fmalpartida/hobby-lights/README.md

# hobby-lights
Small light sequencer for hobby projects.
