fmalpartida/hobby-lights/hw/hobbyLights.brd

## EAGLE design hw/hobbyLights.brd (2016-06-05)

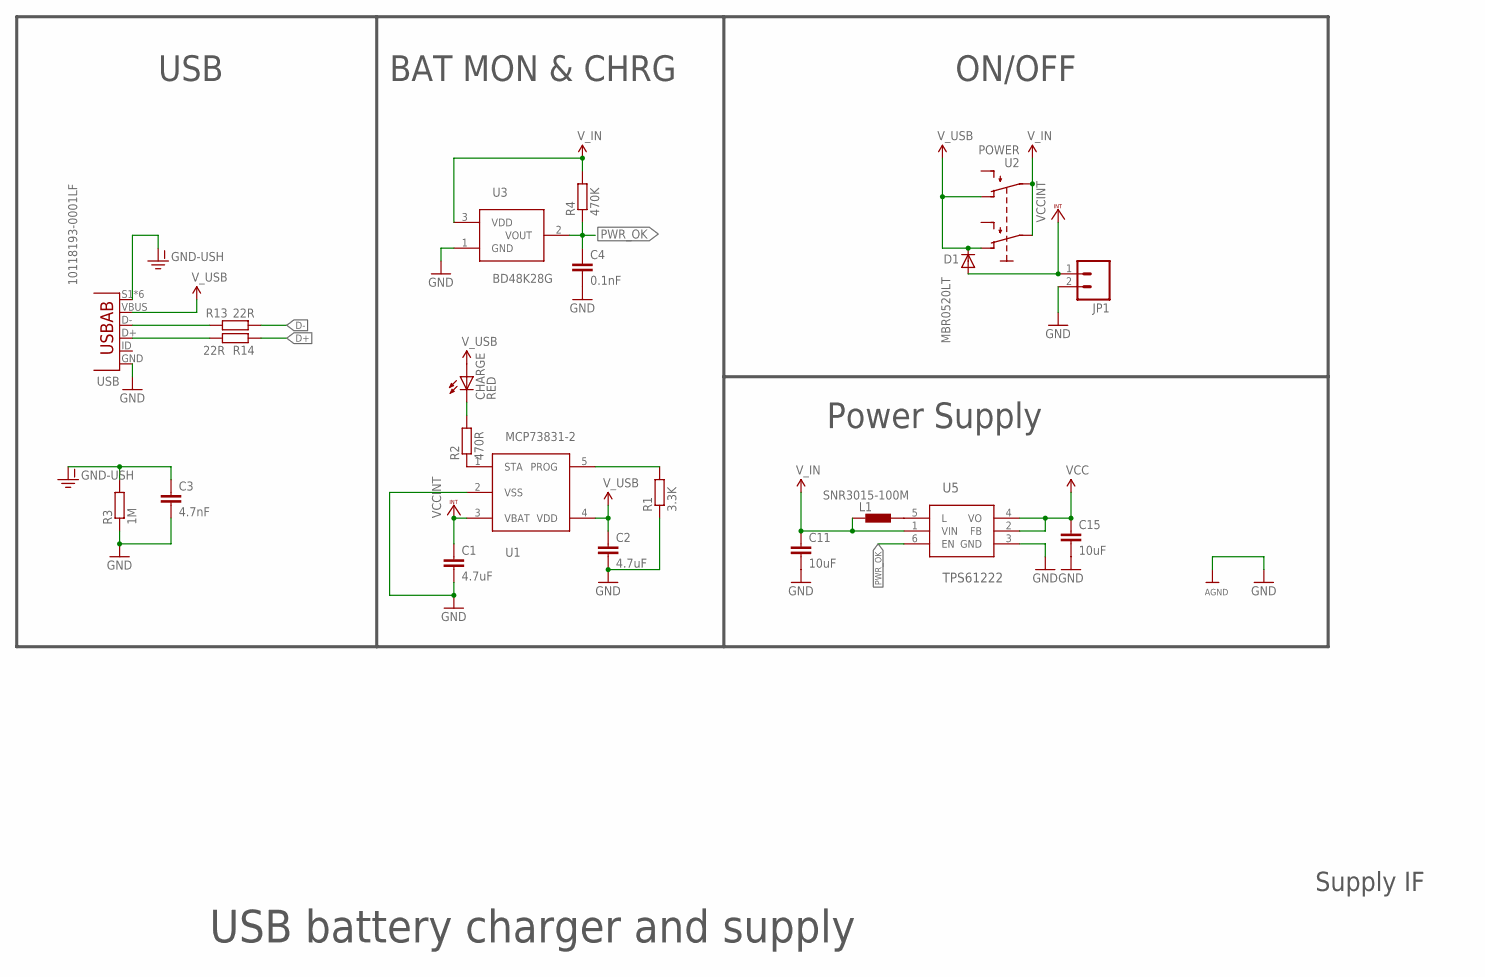
[picture p1: schematic hobbyLights.sch, sheet 1]

Parts:
C1, C2: 4.7uF; C0805
C3: 4.7nF; C0603
C4: 0.1nF; C0603
C11, C15: 10uF; C0805
CHARGE: RED; CHIPLED_0805
D1: MBR0520LT; SOD123
JP1: SPARKFUN_M02POLAR; SPARKFUN_MOLEX-1X2
L1: SNR3015-100M; SRN3015
R1: 3.3K; R0603
R2: 470R; R0603
R3: 1M; R0603
R4: 470K; R0603
R13, R14: 22R; R0603
U1: MCP73831-2; SOT23-5
U2: POWER; SWITCH-JS202011
U3: BD48K28G; SSOP3
U5: TPS61222; DCK
USB: 10118193-0001LF; USB_MICRO_B

Connections:
D+: R14.1; also elsewhere on the board
D-: R13.1; also elsewhere on the board
GND: C1.2, C2.2, C3.2, C4.2, C11.2, C15.2, JP1.2, R1.1, R3.1, U1.2 (VSS), U3.1 (GND), U5.3 (GND), USB.GND; also elsewhere on the board
GND-ISO: C3.1, R3.2, USB.S1 (SHIELD), USB.S2 (SHIELD), USB.S3 (SHIELD), USB.S4 (SHIELD), USB.S5 (SHIELD), USB.S6 (SHIELD)
unnamed: R1.2, U1.5 (PROG)
unnamed: R2.1, U1.1 (STA)
unnamed: CHARGE.C, R2.2
unnamed: R13.2, USB.D-
unnamed: R14.2, USB.D+
unnamed: L1.2, U5.5 (L)
PWR_OK: C4.1, R4.1, U3.2 (VOUT), U5.6 (EN)
VCC: C15.1, U5.2 (FB), U5.4 (VO); also elsewhere on the board
VCCINT: C1.1, D1.A, JP1.1, U1.3 (VBAT)
V_BATT: C11.1, L1.1, R4.2, U2.P2, U2.P5 (P1), U3.3 (VDD), U5.1 (VIN)
V_USB: C2.1, CHARGE.A, D1.C, U1.4 (VDD), U2.P1 (O), U2.P4 (O1), USB.VBUS

Notes on the sheet:
USB
BAT MON & CHRG
Power Supply
ON/OFF
USB battery charger and supply
Supply IF

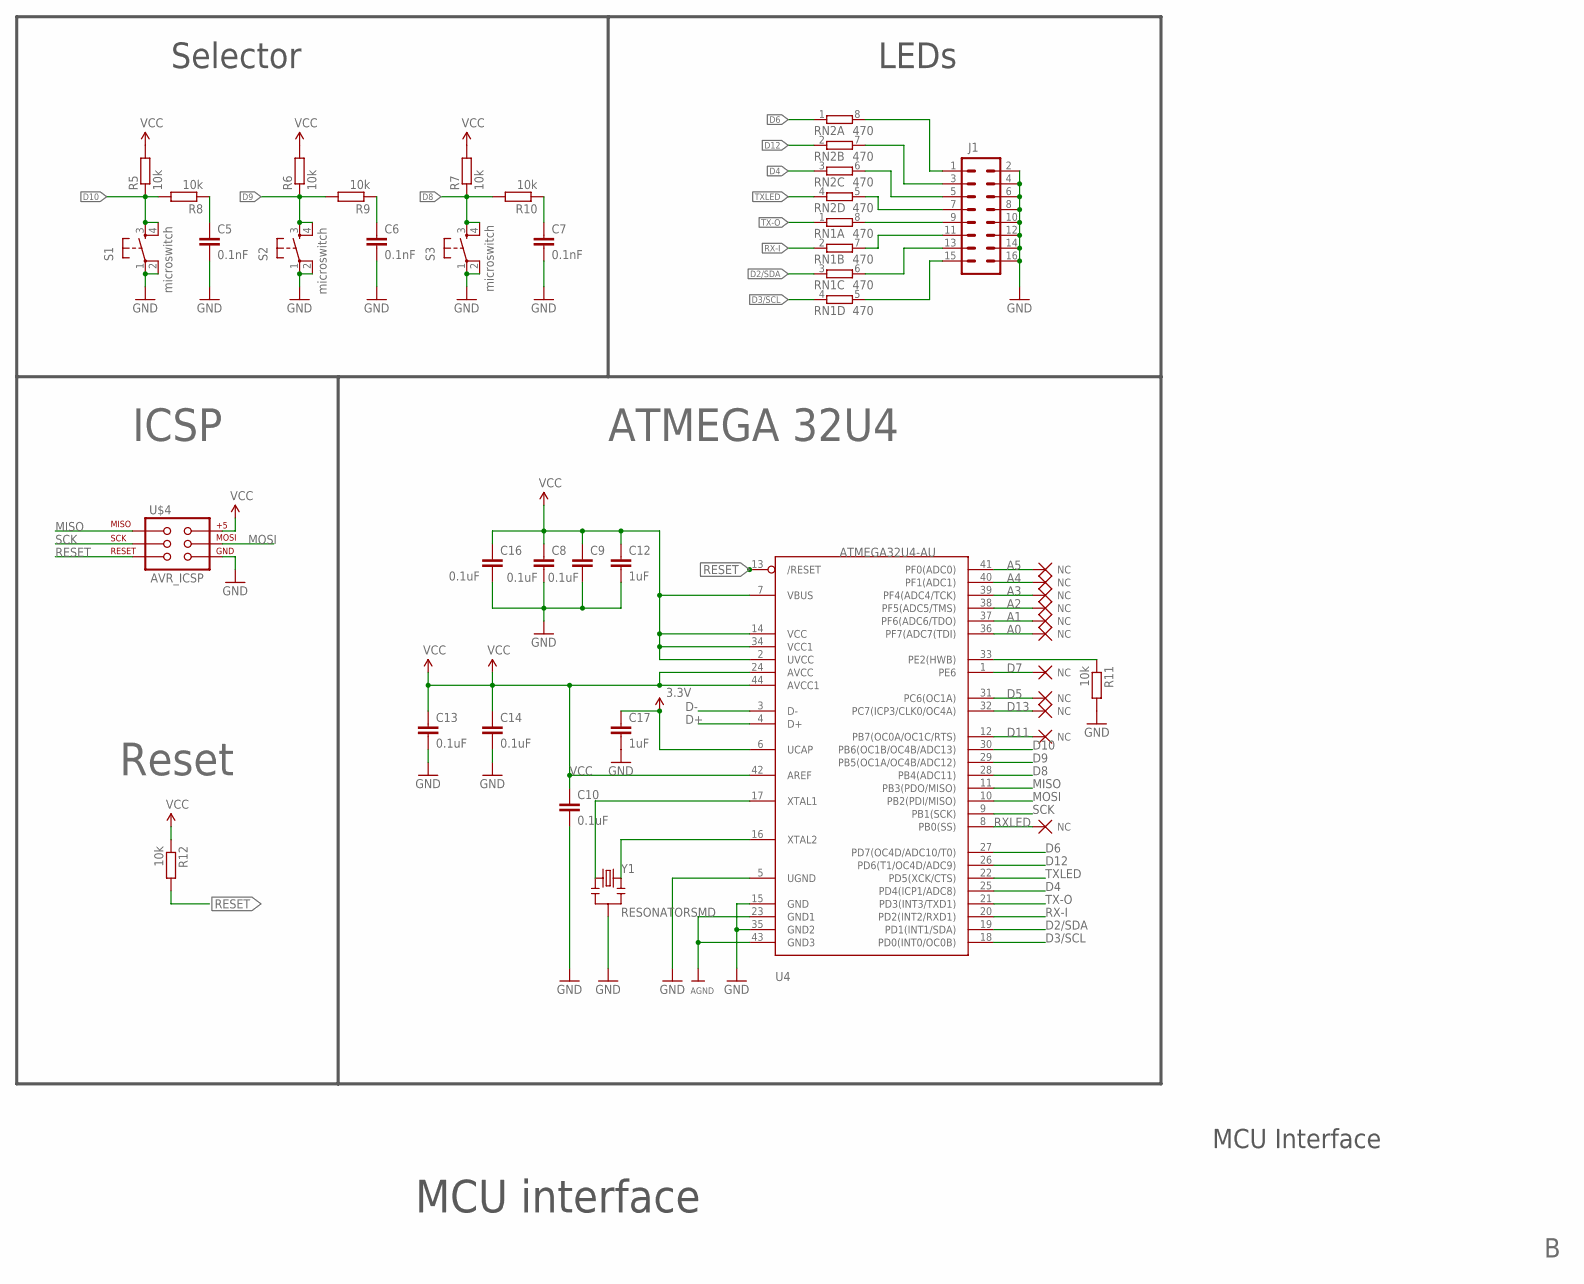
[picture p2: schematic hobbyLights.sch, sheet 2]

Parts:
C5, C6, C7: 0.1nF; C0603
C8, C9, C10, C13, C14, C16: 0.1uF; C0603
C12, C17: 1uF; C0603
J1: M08X2; 2X8
R5, R6, R7, R8, R9, R10, R11, R12: 10k; R0603
RN1, RN2: 470; EXBS8V
S1, S2, S3: microswitch; SPARKFUN_TACTILE_SWITCH_SMD
U4: ATMEGA32U4-AU; ADAFRUIT_TQFP44
U$4: AVR_ICSP; ICSP_SMD
Y1: RESONATORSMD; RESONATOR-SMD

Connections:
3.3V: C17.1, U4.6 (UCAP)
A0: U4.36 (PF7(ADC7(TDI))
A1: U4.37 (PF6(ADC6/TDO))
A2: U4.38 (PF5(ADC5/TMS))
A3: U4.39 (PF4(ADC4/TCK))
A4: U4.40 (PF1(ADC1))
A5: U4.41 (PF0(ADC0))
D2/SDA: RN1.3 (1), U4.19 (PD1(INT1/SDA))
D3/SCL: RN1.4 (1), U4.18 (PD0(INT0/OC0B))
D4: RN2.3 (1), U4.25 (PD4(ICP1/ADC8))
D5: U4.31 (PC6(OC1A))
D6: RN2.1, U4.27 (PD7(OC4D/ADC10/T0))
D7: U4.1 (PE6)
D8: R7.1, R10.2, S3.3, S3.4, U4.28 (PB4(ADC11))
D9: R6.1, R9.2, S2.3, S2.4, U4.29 (PB5(OC1A/OC4B/ADC12))
D10: R5.1, R8.2, S1.3, S1.4, U4.30 (PB6(OC1B/OC4B/ADC13))
D11: U4.12 (PB7(OC0A/OC1C/RTS))
D12: RN2.2 (1), U4.26 (PD6(T1/OC4D/ADC9))
D13: U4.32 (PC7(ICP3/CLK0/OC4A))
D+: U4.4 (D+); also elsewhere on the board
D-: U4.3 (D-); also elsewhere on the board
GND: C5.2, C6.2, C7.2, C8.2, C9.2, C10.2, C12.2, C13.2, C14.2, C16.2, C17.2, J1.2, J1.4, J1.6, J1.8, J1.10, J1.12, J1.14, J1.16, R11.2, S1.1, S1.2, S2.1, S2.2, S3.1, S3.2, U4.5 (UGND), U4.15 (GND), U4.23 (GND1), U4.35 (GND2), U4.43 (GND3), U$4.GND, Y1.2; also elsewhere on the board
MISO: U4.11 (PB3(PDO/MISO)), U$4.MISO
MOSI: U4.10 (PB2(PDI/MISO)), U$4.MOSI
unnamed: C5.1, R8.1
unnamed: U4.16 (XTAL2), Y1.3
unnamed: U4.17 (XTAL1), Y1.1
unnamed: C6.1, R9.1
unnamed: C7.1, R10.1
unnamed: R11.1, U4.33 (PE2(HWB))
unnamed: J1.15, RN1.5 (2)
unnamed: J1.13, RN1.6 (2)
unnamed: J1.11, RN1.7 (2)
unnamed: J1.9, RN1.8 (2)
unnamed: J1.1, RN2.8 (2)
unnamed: J1.3, RN2.7 (2)
unnamed: J1.5, RN2.6 (2)
unnamed: J1.7, RN2.5 (2)
RESET: R12.2, U4.13 (/RESET), U$4.RESET
RX-I: RN1.2 (1), U4.20 (PD2(INT2/RXD1))
RXLED: U4.8 (PB0(SS))
SCK: U4.9 (PB1(SCK)), U$4.SCK
TX-O: RN1.1, U4.21 (PD3(INT3/TXD1))
TXLED: RN2.4 (1), U4.22 (PD5(XCK/CTS))
VCC: C8.1, C9.1, C10.1, C12.1, C13.1, C14.1, C16.1, R5.2, R6.2, R7.2, R12.1, U4.2 (UVCC), U4.7 (VBUS), U4.14 (VCC), U4.24 (AVCC), U4.34 (VCC1), U4.42 (AREF), U4.44 (AVCC1), U$4.5V (+5V); also elsewhere on the board

Notes on the sheet:
ATMEGA 32U4
Reset
ICSP
Selector
LEDs
MCU interface
MCU Interface

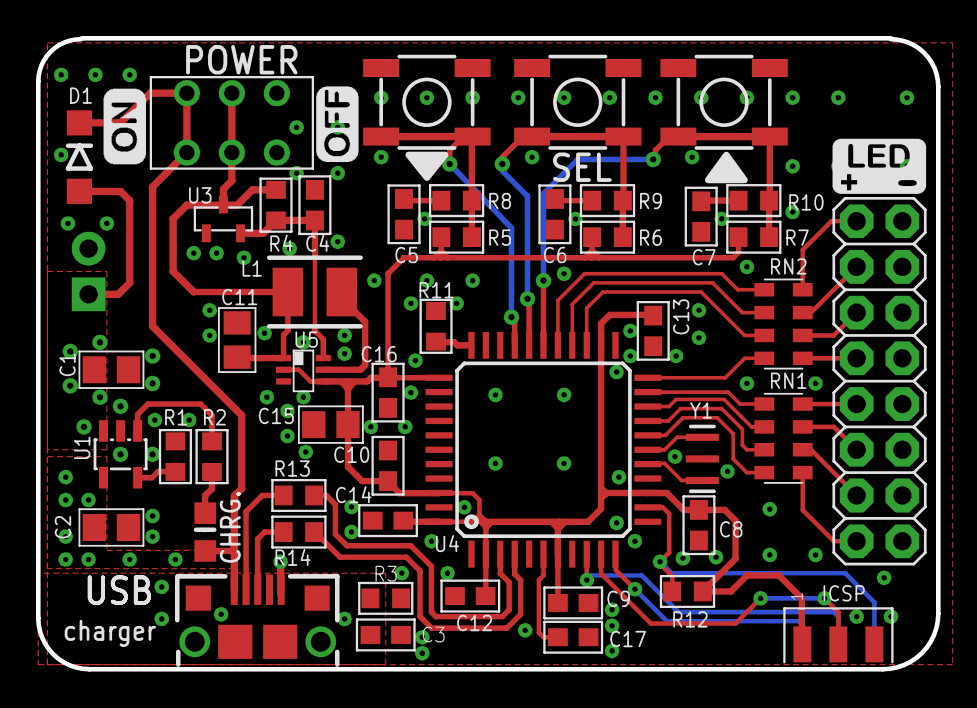
[picture p3: board hobbyLights.brd from above]

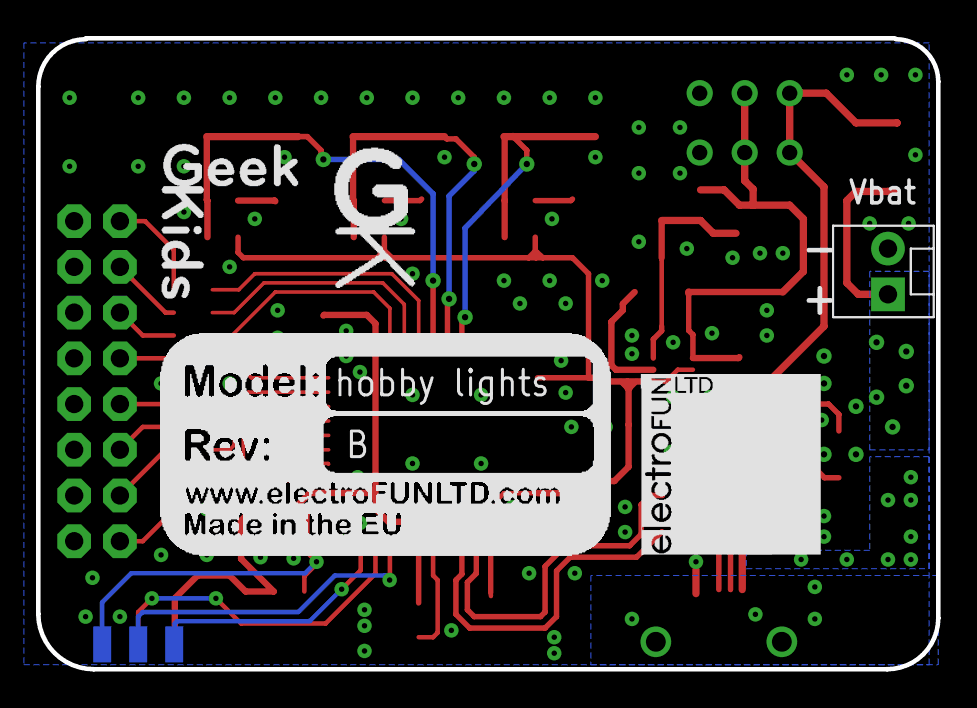
[picture p4: board hobbyLights.brd from below]

Board: 2 copper layers, 50.0 x 35.1 mm, 57 parts (6 on the bottom side), 45 nets.

Other parts of the board:
U$1: LED_SILK
U$2: ON
U$3: OFF
U$5: ELECTROFUN_10X10
U$6, U$10: BOARD_REF
U$7: GEEKKIDS_S
U$11: GEEKKIDS_LOGO_S
