fmalpartida/hobby-lights/(commit log)

2016-03-26 Reworked entire project: - included references to sequencing tables as opposed to sequencer objects. - included additional support for managing programs. - added serial interface support to select: p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
    [main.cpp]
2016-04-03 Added HW to the project.
    [hobbyLights.brd, hobbyLights.sch]
2016-04-03 Updated diodes and added frames.
    [hobbyLights.brd, hobbyLights.sch]
2016-04-03 Removed side boards.
    [hobbyLights.brd, hobbyLights.sch]
2016-04-10 Minor reviews on the PCB
    [hobbyLights.brd]
2016-04-10 Added interrupt management for unattended sequencing. Added new sequence for fast blink.
2016-04-16 Adding button support
2016-04-16 Added capability to load program or not from memory. Avoid writing back to EEPROM the loaded program during initialisation. Added local echo and changed f command by s.
    [main.cpp]
2016-04-17 Added controller, updated buttons and associated methods. Renamed class variables for usage.
2016-04-29 Updated PCB removing daughter motor boards.
    [hobbyLights.brd, hobbyLights.sch]
2016-05-01 Initial program configuration.
    [hobbyLights.brd]
2016-05-01 Updated buttons so that they don't use new by composition in the controller. Refactored button configuration initialisation.
2016-05-01 Updated schematic for Rev B.
    [hobbyLights.brd, hobbyLights.sch]
2016-05-01 Updates for production - Rev B
    [hobbyLights.brd, hobbyLights.sch]
2016-05-15 Fixed button direction to match serigraphy and added reset program action on double click on the select button.
2016-05-28 Minor modifications and upgrade to Eagle 7.6.0
    [hobbyLights.brd, hobbyLights.sch]
2016-06-04 HW: - updated resistor values to increase LED brightness. - updated resistor values to increase charge current. SW: - added new blink program - added new serial line command i.
    [hobbyLights.brd, hobbyLights.sch]
